jamierowl13/esp32-animated-eyes/docs/ESP32_Eyes_Project_Summary.docx

ESP32 Animated Eyes

Dual round-display animated eyes with joystick, button, serial and web control

# Overview

This project drives two 1.28-inch GC9A01 round IPS displays (240 × 240 pixels) from an ESP32 to create a pair of animated eyes. The eyes look around and blink on their own, and they can be taken over manually with an analog joystick, a web control panel served by the ESP32 over WiFi, or text commands typed into the Arduino serial monitor. A push button cycles through the different eye designs.

It suits animatronics, Halloween props, robot heads, cosplay pieces and desk toys, and the code is organised so new eye styles and expressions can be added by editing two small tables.

# Features

- Six eye styles: Human, Cat, Robot, Dragon, Cartoon and Alien, each with its own iris, pupil and eyelid colours.
- Six expressions: Normal, Happy, Sleepy, Angry, Sad and Surprised, with eyelids that ease smoothly between shapes.
- Lifelike automatic behaviour: random saccades, natural blinking (including occasional double blinks), eyelids that follow vertical gaze, and gentle pupil “breathing”.
- Joystick control: move to aim the eyes, press to blink, long-press to re-centre. Automatic movement resumes three seconds after release.
- Mode button: short press for the next style, long press to toggle automatic movement.
- Web control panel: a drag-the-iris look pad, style and expression buttons, blink and wink, settings and live status, usable from a phone.
- Serial monitor: a full command set at 115200 baud, plus event logging and a joystick debug readout.
- WiFi access point and mDNS: the ESP32 creates its own network and can also join a home router, reachable at http://eyes.local.

# Hardware

## Parts list

- ESP32 development board (DevKit V1 / WROOM-32)
- 2 × 1.28-inch GC9A01 240 × 240 round IPS TFT display (SPI)
- Analog joystick module (+5V, GND, VRx, VRy, SW)
- Momentary push button
- Breadboard or perfboard and jumper wires

## Wiring

Component | Module pin | ESP32 pin | Notes
Both displays | VCC / GND | 3.3V / GND | Wired in parallel
Both displays | SCL / SDA | GPIO 18 / GPIO 23 | Shared SPI clock and data
Both displays | DC / RST | GPIO 2 / GPIO 4 | Shared
Both displays | BL | 3.3V | Only if the module has a BL pin
Left display | CS | GPIO 5 | Separate chip select
Right display | CS | GPIO 27 | Separate chip select
Joystick | +5V / GND | 3.3V / GND | Must be 3.3V to protect the ADC
Joystick | VRx / VRy | GPIO 34 / GPIO 35 | ADC1, works with WiFi on
Joystick | SW | GPIO 32 | Internal pull-up
Mode button | Two legs | GPIO 33 and GND | Internal pull-up

Important: power the joystick from 3.3V even though it is labelled +5V. At 5V its analog outputs can exceed 3.3V and damage the ESP32’s ADC pins. GPIO 34 and 35 were chosen because they are on ADC1, which keeps working while WiFi is active.

# Software setup

The sketch is built with the Arduino IDE and the ESP32 board package. WiFi, WebServer and ESPmDNS are included with the board package; the only extra library is TFT_eSPI by Bodmer.

- Install TFT_eSPI from the Arduino Library Manager.
- Copy the supplied User_Setup.h over the one in Arduino/libraries/TFT_eSPI/. The library only reads its own folder, so this step is required.
- Place ESP32_Eyes.ino and web_page.h together in a folder named ESP32_Eyes and upload.
- Keep the joystick still while the board boots, as it calibrates its centre position at start-up.

If the board crashes at boot or the sketch fails to compile, install ESP32 board package version 2.0.17, since TFT_eSPI has known issues with the 3.x series.

## Project files

File | Contents
ESP32_Eyes.ino | Main sketch: rendering, animation, inputs, serial commands, WiFi and web server
web_page.h | The control panel HTML, CSS and JavaScript, stored in flash
User_Setup.h | TFT_eSPI configuration for two GC9A01 displays

# Using the eyes

## Physical controls

Control | Short press / move | Long press
Mode button | Next eye style | Toggle automatic movement
Joystick stick | Aim the eyes | –
Joystick button (SW) | Blink both eyes | Re-centre the joystick

## Web control panel

Join the WiFi network ESP32-Eyes (password eyes1234) and open http://192.168.4.1. If home WiFi details are entered at the top of the sketch, the panel is also available on the home network and at http://eyes.local. The panel uses only system fonts, so it works without an internet connection.

The look pad is drawn as an eyeball: drag the iris to aim the eyes, and a dashed ring shows where they are actually looking. Arrow keys nudge the gaze and the space bar blinks. Settings cover automatic movement, automatic blinking, snapping back to automatic on release, pupil size and joystick re-centring.

An interactive browser demo of the panel, with simulated displays, is available here: Eye control demo (https://claude.ai/artifact/PhhnnKa2CeKNsgUs13PXES)

## Serial monitor commands

Open the serial monitor at 115200 baud. Commands work with any line-ending setting.

Command | What it does
help | List all commands
status | Show style, expression, gaze, pupil, frame rate and free memory
styles | List the eye styles with their numbers
style <n|name> | Choose a style, e.g. style 2 or style cat
next / prev | Next or previous style
expr <n|name> | Choose an expression, e.g. expr angry
blink | Blink both eyes
wink <l|r> | Wink the left or right eye
look <x> <y> | Look at a position, each value from -100 to 100
center | Release manual control and return to automatic
auto <on|off> | Turn automatic eye movement on or off
autoblink <on|off> | Turn automatic blinking on or off
pupil <30..200> | Set pupil size in percent
cal | Re-centre the joystick
joy | Toggle a live joystick readout
wifi | Show network addresses

## Web API

The control panel talks to the ESP32 through simple HTTP GET requests, so the eyes can also be driven from other scripts or home-automation tools.

Endpoint | Purpose
/ | Serves the control panel page
/api/status | Returns the current state as JSON
/api/style?i=N or ?dir=next|prev | Change eye style
/api/expr?i=N | Change expression
/api/look?x=&y= | Aim the eyes (-1 to 1 on each axis)
/api/release | Return to automatic movement
/api/blink?eye=both|left|right | Blink or wink
/api/auto?move=0|1&blink=0|1 | Automatic movement and blinking
/api/pupil?v=0.3..2.0 | Pupil size
/api/calibrate | Re-centre the joystick

# How it works

## Two displays on one SPI bus

Both displays share the clock, data, DC and reset lines and have separate chip-select pins. TFT_eSPI is configured with TFT_CS set to -1 and the sketch drives the two CS pins itself. At start-up both are pulled low so the two panels receive the initialisation sequence together; afterwards each frame is sent to one display at a time.

## Band rendering

A full 240 × 240 frame buffer needs 115 KB, which is hard to allocate alongside WiFi on an ESP32 without PSRAM. Instead each eye is drawn into a 240 × 80 sprite (38 KB) three times, once per horizontal band, and each band is pushed to the display as it is finished. Buttons are polled between bands so they stay responsive.

## Drawing the eye

Each frame draws a shaded sclera, then the iris for the current style using concentric gradient circles, radial texture lines, the pupil and highlights. The eyelids are drawn column by column using a curve with a centre height, a corner curvature and a tilt. Expressions are simply different values for those parameters, and a blink blends the curves towards a closed line. Tilt is mirrored between the left and right eye so Angry and Sad slope towards the face.

## Movement

In automatic mode the target gaze jumps to a random point every 0.5 to 3.5 seconds, with a bias towards looking straight ahead, and the actual gaze eases towards it to mimic quick eye movements. Joystick, web and serial input set the target directly and pause automatic movement for three seconds.

# Configuration

All user settings are at the top of ESP32_Eyes.ino:

Setting | Purpose
AP_SSID / AP_PASS | Name and password of the ESP32’s own WiFi network
STA_SSID / STA_PASS | Optional home WiFi to join as well
Pin definitions | Change if your wiring differs
USE_JOYSTICK | Set to false if no joystick is fitted, to avoid random drift
JOY_INVERT_X / _Y, JOY_SWAP_XY | Fix joystick direction or rotation
SWAP_EYES | Fix mirrored Angry/Sad lids
LEFT_ / RIGHT_ROTATION | Rotate each display if mounted turned
MANUAL_HOLD_MS | Delay before automatic movement resumes

# Troubleshooting

Symptom | Fix
Blank or white screens | Check that User_Setup.h was copied into the TFT_eSPI library folder and that the CS wires go to GPIO 5 and 27
Garbled image | Lower SPI_FREQUENCY to 27000000 and shorten the wires
Eyes drift with no joystick | Set USE_JOYSTICK to false
Joystick moves the wrong way | Use the invert and swap settings
Crash at boot or compile errors | Use ESP32 board package 2.0.17
Cannot open the web page | Join the ESP32-Eyes network first, then browse to http://192.168.4.1

# Ideas for extending the project

- Add a PIR or ultrasonic sensor so the eyes track or react to people nearby.
- Drive the backlight with PWM for brightness control and a sleep mode.
- Add a microphone so the eyes widen at loud sounds.
- Use an ESP32-S3 with PSRAM for full-frame rendering and higher frame rates.
- Store the chosen style and settings in flash so they survive a restart.

ESP32 Animated Eyes – page
